Sparxx947/shelly-tueroeffner/docs/gehaeuse.en.md

🇩🇪 [Deutsche Version](gehaeuse.md)

# DIN-rail enclosure (2 modules)

The Shelly sits in a custom enclosure shaped like a miniature circuit breaker: **2 modules wide (34.6 mm), 90 mm
high, 45 mm front collar, 44 mm to the shoulder, 55 mm overall depth** (DIN 43880 size 1). It snaps onto a TS35
rail like a breaker. Source: [`gehaeuse/tueroeffner-gehaeuse.scad`](../gehaeuse/tueroeffner-gehaeuse.scad),
ready to print: `tueroeffner_koerper.stl` (body), `tueroeffner_deckel.stl` (lid).

## Design

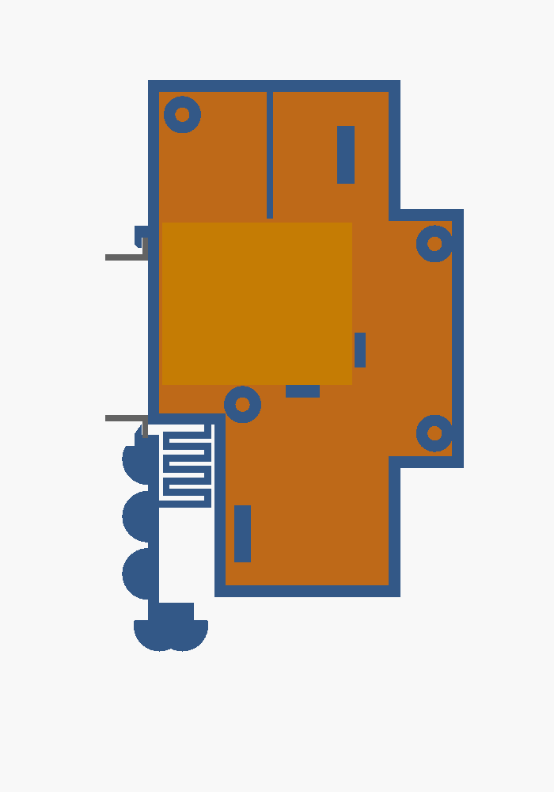
[picture p1: gehaeuse/ansicht-offen.png]
View of the open side


*Looking at the open side (lid removed): rail (grey) on the left, collar on the right. The Shelly is shown in orange.*

| Part | Purpose |
|---|---|
| Top hook (fixed) | grips behind the upper flange |
| Bottom latch with meander spring | snaps behind the lower flange, 0.65 mm preload. **Release:** insert a screwdriver from the front into the slot of the tab at the bottom and pull down (≈ 3 mm) |
| Shelly pocket | back against the left wall, label and terminal screws facing the lid, terminal strip on top. Front stop, bottom ledge, pressure pin in the lid (0.5 mm gap, add an adhesive pad if needed) |
| Divider | in the body above the terminal strip **between I and L**, in the lid beside the Shelly down to the floor → **front: mains (L, N), rear: door-opener circuit (SW, O, I)** |
| Entry top front, Ø 6.5 | mains cord (Euro power cord 2 × 0.75 mm²), cable-tie anchor below |
| Entry bottom rear, Ø 5.5 | door-opener wires, cable-tie anchor next to it |
| Lid | right side wall, 4 self-tapping screws 2.9 × 13 |

## Measure before printing ★

| Dimension | Assumed in the model | Parameter |
|---|---|---|
| Shelly | ✅ **re-measured 2026-10-22:** 33.46 × 28.24 × 16.07 mm (10-21: 33.16 length); 0.25 mm clearance per side lengthwise, divider 0.6 mm above the strip as upper stop, two pressure pins in the lid with 0.2 mm clearance (datasheet 34 × 29 × 16) | `sh_l`, `sh_h`, `sh_t` |
| Terminals I–L centre to centre | ✅ **measured:** 5.0 mm → divider 1.0 mm thick, starts 2 mm above the terminal strip | `kl_teilung`, `steg_t`, `steg_luft` |
| Terminal centre from the Shelly's back (thickness) | ✅ **measured:** 6.5 mm | – |
| Position of the I/L midpoint along the length | ✅ **measured:** 19.0 mm from the SW edge (divider at y = 21.5) | `sw_bis_il` |
| Depth rail → cover on your own breaker | 44 mm (standard: ≤ 44) | `T_sch` |
| Collar fits through the cover cut-out | 45 mm (cut-out usually 46) | `H_krag` |

## Checks (OpenSCAD)

`openscad -D 'TEIL="pruef_shelly"' …` etc. Each check is an intersection and must be **empty or 0 mm³**.

| Check | Result 2026-10-21 | Alarm path proven with |
|---|---|---|
| `pruef_shelly` – Shelly vs body + lid | 0 mm³ (contact face only) | Shelly 3 mm lower → 212.7 mm³ |
| `pruef_riegel` – latch pulled 3 mm vs body | empty | latch 3 mm up → 90.0 mm³ |
| `pruef_schiene` – latched rail vs enclosure | 0 mm³ (contact only) | nose 0.65 mm too thick → 56.4 mm³ |

## Printing

**Pre-configured for the Bambu Lab P1S:** [`gehaeuse/tueroeffner-gehaeuse-p1s.3mf`](../gehaeuse/tueroeffner-gehaeuse-p1s.3mf) – body and lid on one plate, P1S 0.4 mm, Bambu PETG Basic (255 °C / bed 70 °C), textured PEI plate, 0.20 mm, 3 walls, 4 top/bottom layers, 25 % infill, Arachne, no supports, no brim. Sliced: **1 h 55 min, 51.3 g**. Five **mouse ears** on the latch and its tab are part of the model – break them off after printing. **Do not enable a brim in the slicer:** it puts one line into each gap of the meander spring and welds it solid. After changing dimensions, re-export the STL files and regenerate the 3MF.

- **PETG**, 0.2 mm, 3 walls, no supports. PLA is unsuitable: the spring needs toughness, and it gets warm in the cabinet.
- Print the body on its **left side** (`TEIL="koerper"` rotates it). The spring and hooks then lie in the print plane
  and do not flex against layer adhesion. Print the lid outer face down.
- After printing, pull the latch once by hand to free the 0.6 mm gaps.

## Fire safety – an honest assessment

Printed PETG is **not flame-retardant**. Commercial DIN-rail enclosures are polycarbonate UL94 V-0. The Shelly has
its own closed housing; the printed part is an additional shell. If you want it by the book, print in a V-0
filament (PC-FR, PETG-V0) or use an empty enclosure:

| Enclosure | Size | Material | Price (reichelt, 2026-10-21) |
|---|---|---|---|
| CamdenBoss CNMB/2/KIT ("CB HUTKIT 2") | 36 × 90 × 58 mm, floor 86.5 × 33 | PC, UL94 V-0 (grey lid) | €8.15 |
| apra-norm apraRail DB 2 | 36 × 90 × 58 mm | PC, UL94 V-0 | €7.30 |

Both are 58 mm deep (size 2) and fit common small distribution boards, but have no divider and no strain relief.
