Sparxx947/shelly-tueroeffner/docs/verlauf.en.md

🇩🇪 [Deutsche Version](verlauf.md)

# Project history and decisions

| Date | Step | Result / decision |
|---|---|---|
| 2026-10-21 | Starting point | Goal: trigger the front-door strike via Shelly or Sonoff **without touching the existing buttons**. The door-opener circuit is wired all the way to the distribution cabinet (bell transformer Hager ST303, 8 VA, 8 V / 12 V). Principle: potential-free contact **in parallel** with the button, pulse only (auto-off 2–3 s). |
| 10-21 | First recommendation | Shelly 1 Gen4 with a 12 V DC plug-in PSU at the cabinet socket – no mains voltage at the device. 12 V DC supply per reseller data/datasheet, not cross-checked against Shelly's own page. |
| 10-21 | Inventory (photo) | **Shelly 1 Mini Gen3** on hand: potential-free contact O/I, 8 A @ 240 V AC / 5 A @ 30 V DC, but supply **110–240 V AC only** (rating plate). Shelly PM Mini Gen3: no relay → unsuitable. In-wall relay with switched L output (probably Sonoff MINI, label unreadable) → unsuitable, would put mains voltage into the bell circuit. |
| 10-21 | Decision | **Shelly 1 Mini Gen3 from stock**, powered via a Schuko power cord from the cabinet socket. Shelly 1 Gen4 (12 V DC) remains the fallback if no mains voltage should reach the Shelly. |
| 10-21 | Tasmota checked | mgos32-to-tasmota32: Mini1G3 tested, but only from Shelly firmware 1.3.x; ≥ 1.5.x unsupported, development stopped, no way back. **Decision: stock Shelly firmware** (local, cloud off). |
| 10-21 | Enclosure | Goal: snap on like a breaker. Custom 2-module design per DIN 43880 (OpenSCAD) with fixed top hook, meander-spring latch at the bottom, divider between I and L (mains front, door opener rear), strain reliefs. Collision checks 0 mm³, alarm path proven for each check. Flange width corrected to 4 mm (not 5) after research. Commercial UL94 V-0 alternative: CamdenBoss CNMB/2/KIT (€8.15). Shelly dimensions and terminal positions not yet measured. |
| 10-21 | 3MF for P1S | Shelly measured (33.16 × 28.24 × 16.08 mm, I–L 5.0 mm, terminal centre 6.5 mm from the back, SW edge → I/L midpoint 19.0 mm) → model adjusted, divider 1.0 mm, 2 mm above the strip. Pre-configured print file (PETG Basic, textured PEI, 0.20 mm, 3 walls, Arachne): 1 h 55 min, 51.9 g; verified by re-loading it in Bambu Studio. |
| 10-22 | Second print prepared | First print: meander spring (full 34.6 mm width, 0.8 mm strands) came off the bed during printing; Shelly had play (0.5 mm per side lengthwise + real length 33.46 instead of 33.16, divider 2 mm above the strip, one pressure pin with 0.5 mm clearance). Slicer brim checked: puts lines into the spring gaps → rejected. Spring now only 12 mm wide, strands 1.2 mm (about the same stiffness), clearance 0.25 mm, divider 0.6 mm, two pins with 0.2 mm. 1 h 54 min, 51.3 g. |
| open | Measurement | Which wire the door-opener button switches against pole 4; door-strike rating plate. |
| open | Home Assistant | Shelly integration, button with confirmation, "open door" action in the doorbell notification; not exposed to voice assistants. |
