Sparxx947/shelly-tueroeffner/ha/README.md

🇬🇧 Home Assistant parts follow after installation. · Home-Assistant-Teile folgen nach dem Einbau.
