Sparxx947/shelly-tueroeffner/docs/schaltplan/tueroeffner_schaltplan.png

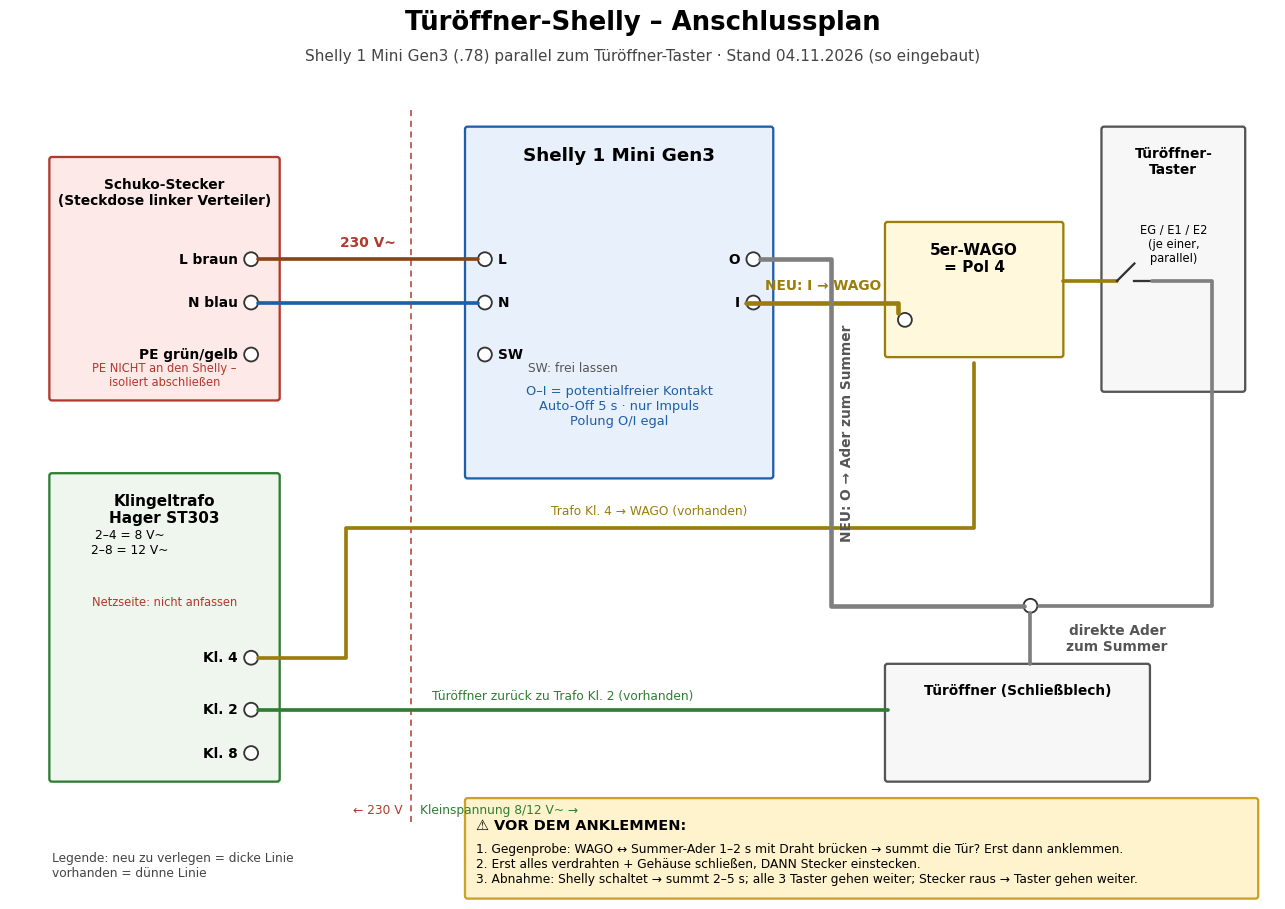
docs/schaltplan/tueroeffner_schaltplan.png
