Sparxx947/shelly-tueroeffner/gehaeuse/tueroeffner-gehaeuse-p1s.3mf

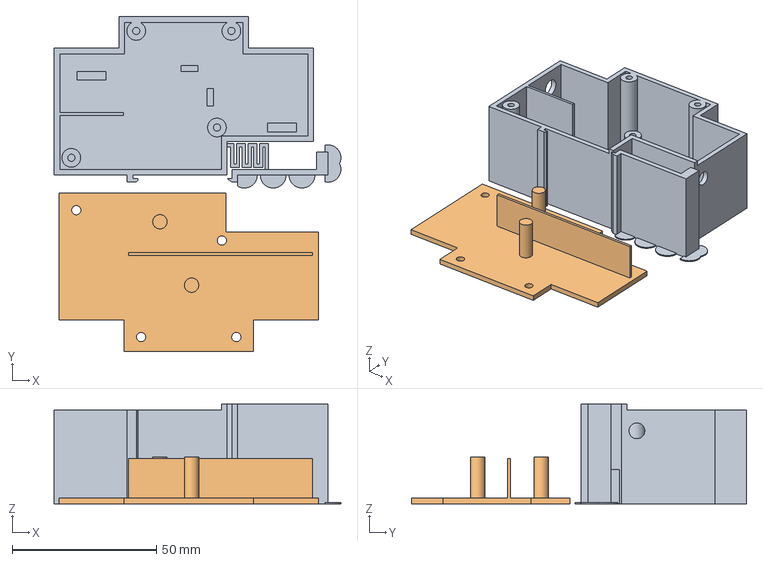
[picture p3: CAD file, 2026-10-22]
gehaeuse/tueroeffner-gehaeuse-p1s.3mf
99.5 x 116.2 x 34.6 mm
Gehaeuse Koerper (auf der Seite)
Gehaeuse Deckel
