Sparxx947/shelly-tueroeffner/gehaeuse/tueroeffner_deckel.stl

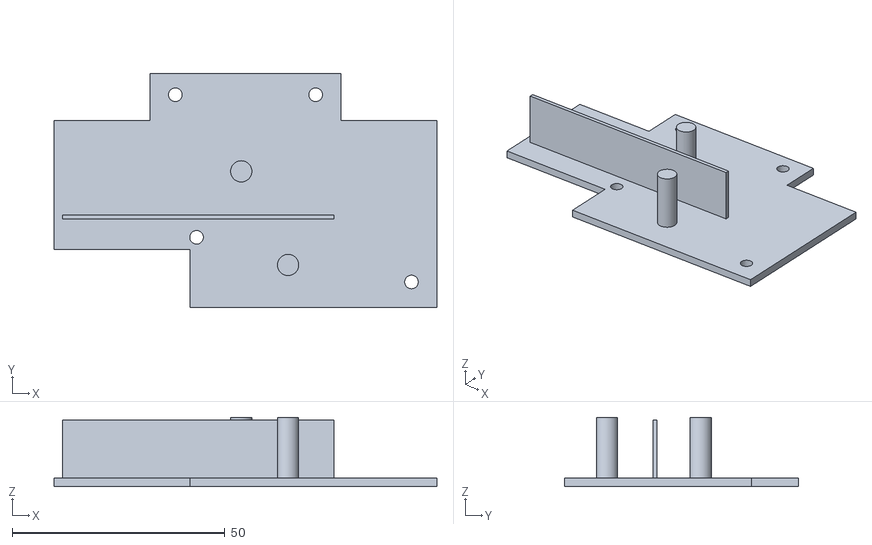
[picture p4: CAD file, 2026-10-22]
gehaeuse/tueroeffner_deckel.stl
90.0 x 55.0 x 16.3
