Sparxx947/shelly-tueroeffner/gehaeuse/tueroeffner_koerper.stl

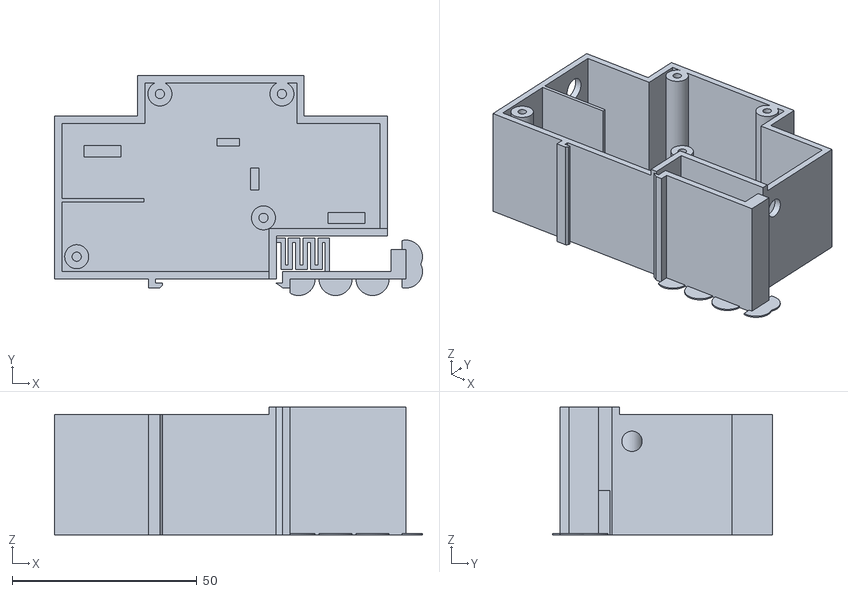
[picture p5: CAD file, 2026-10-22]
gehaeuse/tueroeffner_koerper.stl
99.5 x 59.5 x 34.6
