Sparxx947/shelly-tueroeffner/(commit log)

2026-10-21 Initial project: Shelly 1 Mini Gen3 as door opener in parallel with the existing buttons
    Planning status 2026-10-21: device chosen from stock, wiring and measurement
    plan documented (DE/EN). Open: identify the door-opener wire, HA integration.
2026-10-21 DIN-rail enclosure (2 modules) and Tasmota assessment
    - gehaeuse/: OpenSCAD source, STL body + lid, view of the open side
    - docs/gehaeuse: design, dimensions to measure, collision checks with
    proven alarm path, printing, fire-safety comparison with V-0 enclosures
    - README: firmware decision (stock Shelly; Tasmota OTA conversion not
    supported from firmware 1.5.x), contents table
    - verlauf: Tasmota check and enclosure entries
    Fixes #1
2026-10-21 Ready-to-print Bambu Lab P1S project (3MF)
    Body and lid on one plate; P1S 0.4 mm, Bambu PETG Basic, textured PEI
    plate, 0.20 mm, 3 walls, 25 % infill, Arachne, no supports.
    Sliced: 1 h 57 min, 52.3 g; verified by re-loading in Bambu Studio.
    Fixes #3
2026-10-21 Use measured Shelly dimensions and terminal pitch
    Shelly 33.16 x 28.24 x 16.08 mm, I-L 5.0 mm centre to centre, terminal
    centre 6.5 mm from the back. Divider 1.0 mm thick, starts 2 mm above the
    terminal strip. STL, view and P1S 3MF regenerated (1 h 55 min, 51.9 g);
    collision checks still 0 mm3, alarm path 213.8 mm3.
    Refs #3
2026-10-21 Divider position from measured SW edge to I/L midpoint (19.0 mm)
    All Shelly dimensions are now measured. STL, view and P1S 3MF rebuilt
    (1 h 55 min, 51.9 g); collision checks 0 mm3, alarm path 213.8 mm3.
    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
2026-10-22 Second print: narrower spring, tighter Shelly fit
    First print: the full-width meander spring came off the bed, and the
    Shelly had play in every direction.
    - Spring only 12 mm wide (print height), strands 1.2 mm, gap 0.8 mm;
    stiffness ~ b*t^3 stays about the same
    - Shelly re-measured 2026-10-22: 33.46 x 28.24 x 16.07 mm
    - Clearance 0.25 mm per side lengthwise, divider 0.6 mm above the
    terminal strip as upper stop, two pressure pins in the lid (0.2 mm)
    - Docs: do not enable a slicer brim, it fills the spring gaps
    Fixes #5
2026-10-22 Mouse ears on latch bar and tab
    The first print failed only on the bed around the latch; the spring
    itself printed cleanly higher up. A slicer brim fills the spring gaps,
    so five 0.4 mm ears are modelled on the free outer edges instead
    (three behind the bar, two below the tab). Check ears vs. body/spring
    is empty, alarm path verified. First layer checked in G-code.
    Fixes #7
2026-11-04 Document installation on 2026-11-04, add wiring diagram (#9)
2026-11-04 Wiring as installed: O goes to the direct door-strike wire (#9)
